jft-t/Rotator-Controller/README.md

# Rotator-Controller
Rotator Controller for SPID BigRAS rotator, suited for use within SatNOGS stations
