jft-t/Rotator-Controller/connections.png

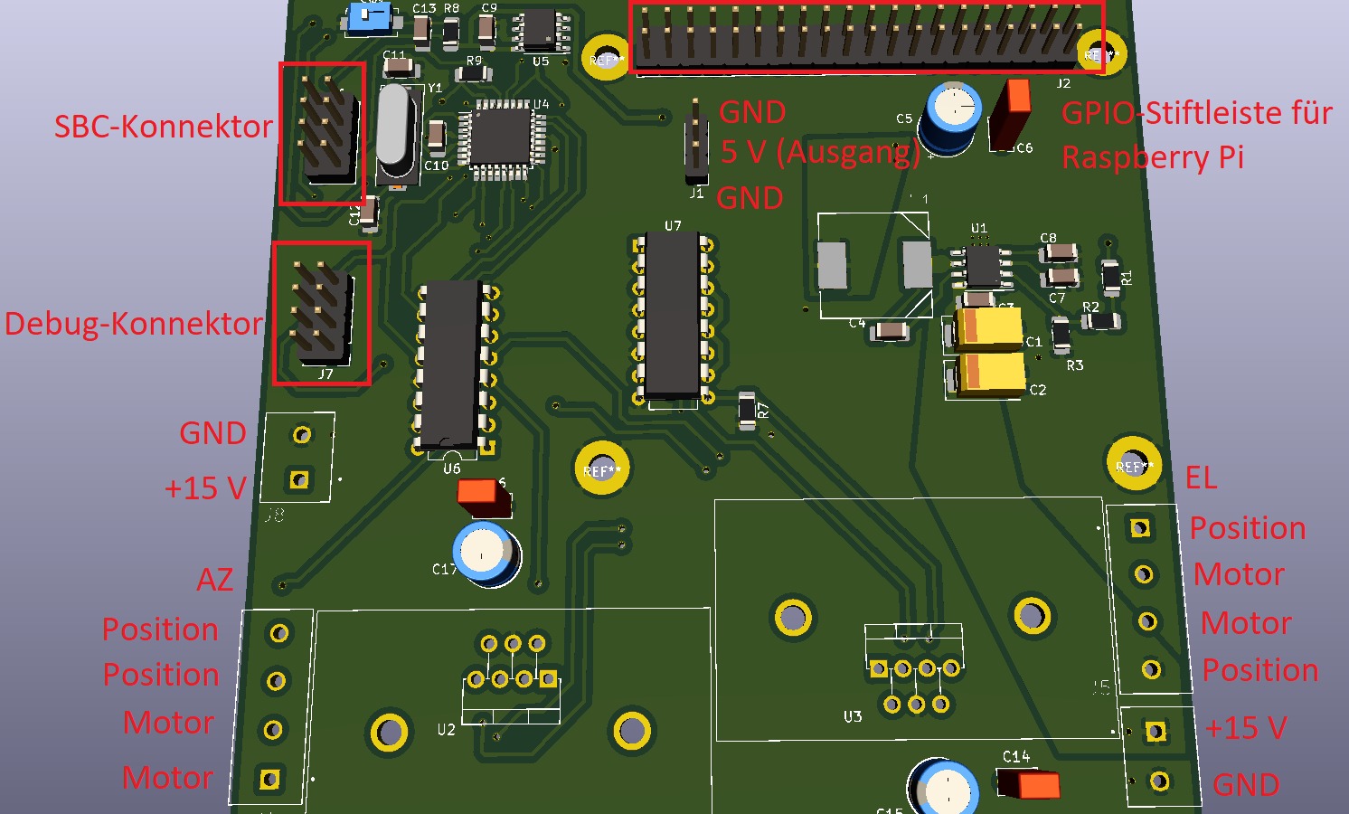
connections.png
