jft-t/Rotator-Controller/bom-controller.xlsx

Sheet: Konnektoren, Schalter
Bezeichnung Schaltplan | Beschreibung | Menge | Einzelpreis in € | Gesamtpreis in € | Link | Bemerkung
J1 | Einfache Stiftleiste | 1 | 0.15 | 0.15 | https://www.pollin.de/p/stiftleiste-vergoldet-1x-7-polig-442428 | wird zurechtgeschnitten
J2 | Stapelbare Stiftleiste für Raspberry Pi | 2 | 1.6 | 3.2 | https://www.sertronics-shop.de/raspberry-pi-co/raspberry-pi/bauelemente/stacking-header-f-252-r-raspberry-2x20-61-40-polig-rm-2-54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 | Abholung im Laden in Adlershof mgl.
J3, J4, J5 | Schraubklemme 2-polig, RM 5mm | 6 | 0.15 | 0.9 | https://www.pollin.de/p/leiterplatten-anschlussklemme-xy301v-2-polig-450856 | J4, J5 durch zusammenstecken
J6, J7 | Stiftleiste, doppelt, 8 Pins, RM 2.54mm | 2 | 0.3 | 0.6 | https://www.pollin.de/p/stiftleiste-450665 | wird zurechtgeschnitten
SW1 | SMD-Taster | 1 | 0.17 | 0.17 | https://www.pollin.de/p/smd-miniatur-eingabetaster-6-1x3-7x2-5-mm-420962
 |  |  |  | 4.7

Sheet: Aktiv
Bezeichnung Schaltplan | Beschreibung | Menge | Einzelpreis in € | Gesamtpreis in € | Link | Bemerkung
U1 | BD9D321EFJ (Buck converter ic) | 1 | 0.64 | 0.64 | https://www.mouser.de/ProductDetail/ROHM-Semiconductor/BD9D321EFJ-E2
U2, U3 | TLE5206-2S Motortreiber | 2 | 4 | 8 | https://www.conrad.de/de/p/infineon-technologies-tle5206-2s-pmic-motortreiber-steuerungen-h-bruecke-parallel-to-220-7-1183765.html | Abholung im Laden in Schöneberg
U4 | ATmega 328P, TQFP-32 | 1 | 1.81 | 1.81 | https://www.mouser.de/ProductDetail/Microchip-Technology-Atmel/ATMEGA328P-AU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
U5 | FM24C04B, F-RAM | 1 | 1.75 | 1.75 | https://www.reichelt.de/fram-4-kb-512-x-8-4-5-5-5-v-so-8-fm-24c04b-g-p146568.html
U6, U7 | Optokoppler LTV-847, 4-Kanal | 2 | 0.71 | 1.42 | https://www.mouser.de/ProductDetail/Lite-On/LTV-847?qs=sGAEpiMZZMteimceiIVCBx3Y662pemTNEFNr76lpuig%3D | wird zurechtgeschnitten
_ | IC-Fassung, 16-polig | 2 | 0.05 | 0.1 | https://www.pollin.de/p/ic-fassung-16-polig-400001
D1 | Z-Diode, 5.1 V, SOD-123 | 1 | 0.24 | 0.24 | https://www.mouser.de/ProductDetail/Vishay-Semiconductors/BZT52C5V1-E3-08
_ | Kühlkörper für TO-220 | 2 | 1.96 | 3.92 | https://www.mouser.de/ProductDetail/Wakefield-Vette/657-25ABEP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 | für 10 bis 14 W Wärmeverluste
 |  |  |  | 13.96

Sheet: Passiv
Bezeichnung Schaltplan | Beschreibung | Menge | Einzelpreis in € | Gesamtpreis in € | Link | Bemerkung
C1, C2 | SMD-Tantalkondensator 33 µF | 2 | 0.1 | 0.2 | https://www.pollin.de/p/smd-tantal-kondensator-210448 | nur 2 benötigt
C3, C4, C9, C10, C13 | SMD-Kermaikkondensator 100 nF | 5 | 0.1 | 0.5 | https://www.mouser.de/ProductDetail/KEMET/C1206C104M5RACTU?qs=sGAEpiMZZMs0AnBnWHyRQAyQ3AEn5kTUXS61cVd4nXQ%3D
C5 | Elektrolytkondensator 100 µF | 1 | 0.28 | 0.28 | https://www.mouser.de/ProductDetail/Panasonic/EEU-FR1E101?qs=sGAEpiMZZMvwFf0viD3Y3chMjVlP8qMGKQRWWtuhRU4%3D | Low-ESR
C6, C14, C16 | Keramikkondensator 100 nF | 3 | 0.06 | 0.18 | https://www.pollin.de/p/keramik-vielschicht-kondensator-100-nf-201048
C7 | SMD-Kermaikkondensator 1 µF | 1 | 0.25 | 0.25 | https://www.mouser.de/ProductDetail/Wurth-Electronics/885012208064
C8 | Keramikkondensator 3,3 nF | 1 | 0.06 | 0.06 | https://www.mouser.de/ProductDetail/Vishay-Vitramon/VJ1206Y332JXAAC
C10, C11 | SMD-Keramikkondensator 22 pF | 2 | 0.11 | 0.22 | https://www.mouser.de/ProductDetail/Wurth-Electronics/885012008039
C15, C17 | Elektrolytkondensator 100 µF | 2 | 0.1 | 0.2 | https://www.pollin.de/p/elko-jamicon-low-e-s-r-100-f-25-v-rm2-5-1050-radial-210874
L1 | SMD-Spule, 100 µH, 3.64 A | 1 | 1.77 | 1.77 | https://www.mouser.de/ProductDetail/Coiltronics-Eaton/DR127-101-R
R1 | SMD-Dickfilmwiderstand, 110k, 0.5 % | 1 | 0.29 | 0.29 | https://www.mouser.de/ProductDetail/Yageo/RT1206DRD07110KL | Hohe Genauigkeit für Tiefsetzsteller
R2 | SMD-Dickfilmwiderstand, 16k, 0.5 % | 1 | 0.29 | 0.29 | https://www.mouser.de/ProductDetail/Susumu/RG3216P-1602-D-T5?qs=sGAEpiMZZMtlubZbdhIBIGPl8NE4eY1fxwWHEzzjGgg%3D | Hohe Genauigkeit für Tiefsetzsteller
R3 | SMD-Dickfilmwiderstand, 22k, 0.5 % | 1 | 0.23 | 0.23 | https://www.mouser.de/ProductDetail/KOA-Speer/SG73G2BTTD2202D | Hohe Genauigkeit für Tiefsetzsteller
R4, R5, R6, R7, R8, R17, R18 | SMD-Dickfilmwiderstand, 10k, 1 % | 7 | 0.09 | 0.63 | https://www.mouser.de/ProductDetail/Vishay-Dale/CRCW120610K0FKEAC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
R9 | SMD-Dickfilmwiderstand, 2k4, 1 % | 1 | 0.09 | 0.09 | https://www.mouser.de/ProductDetail/Vishay-Dale/CRCW12062K40FKEAC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 | Hohe Genauigkeit für UART
R10 | SMD-Dickfilmwiderstand, 4k7, 1 % | 1 | 0.09 | 0.09 | https://www.mouser.de/ProductDetail/Panasonic/ERJ-8ENF4701V?qs=sGAEpiMZZMtlubZbdhIBIOIpaOjkYUZGnQsJq1RaWsg%3D | Hohe Genauigkeit für UART
R11, R12, R13, R14, R15, R16 | SMD-Dickfilmwiderstand, 620, 1 % | 6 | 0.09 | 0.54 | https://www.mouser.de/ProductDetail/Panasonic/ERJ-8ENF6200V
Y1 | Quarz-Kristall, 16 MHz, HC-49 | 1 | 0.26 | 0.26 | https://eu.mouser.com/ProductDetail/IQD/LFXTAL010495Bulk
R19 | SMD-Dickfilmwiderstand, 10, 1 % | 1 | 0.09 | 0.09 | https://www.mouser.de/ProductDetail/Vishay-Dale/CRCW120610R0FKEAC
F1 | SMD-Sicherung, 3.5 A, träge | 1 | 0.2 | 0.2 | https://www.pollin.de/p/smd-sicherung-mit-fassung-littelfuse-015403-5t-260597 | für 5 V-Spannungsversorgung
 |  |  |  | 6.37
