jft-t/Rotator-Controller/kicad/controller.kicad_pcb

## KiCad design kicad/controller.kicad_pcb (2019-08-09)

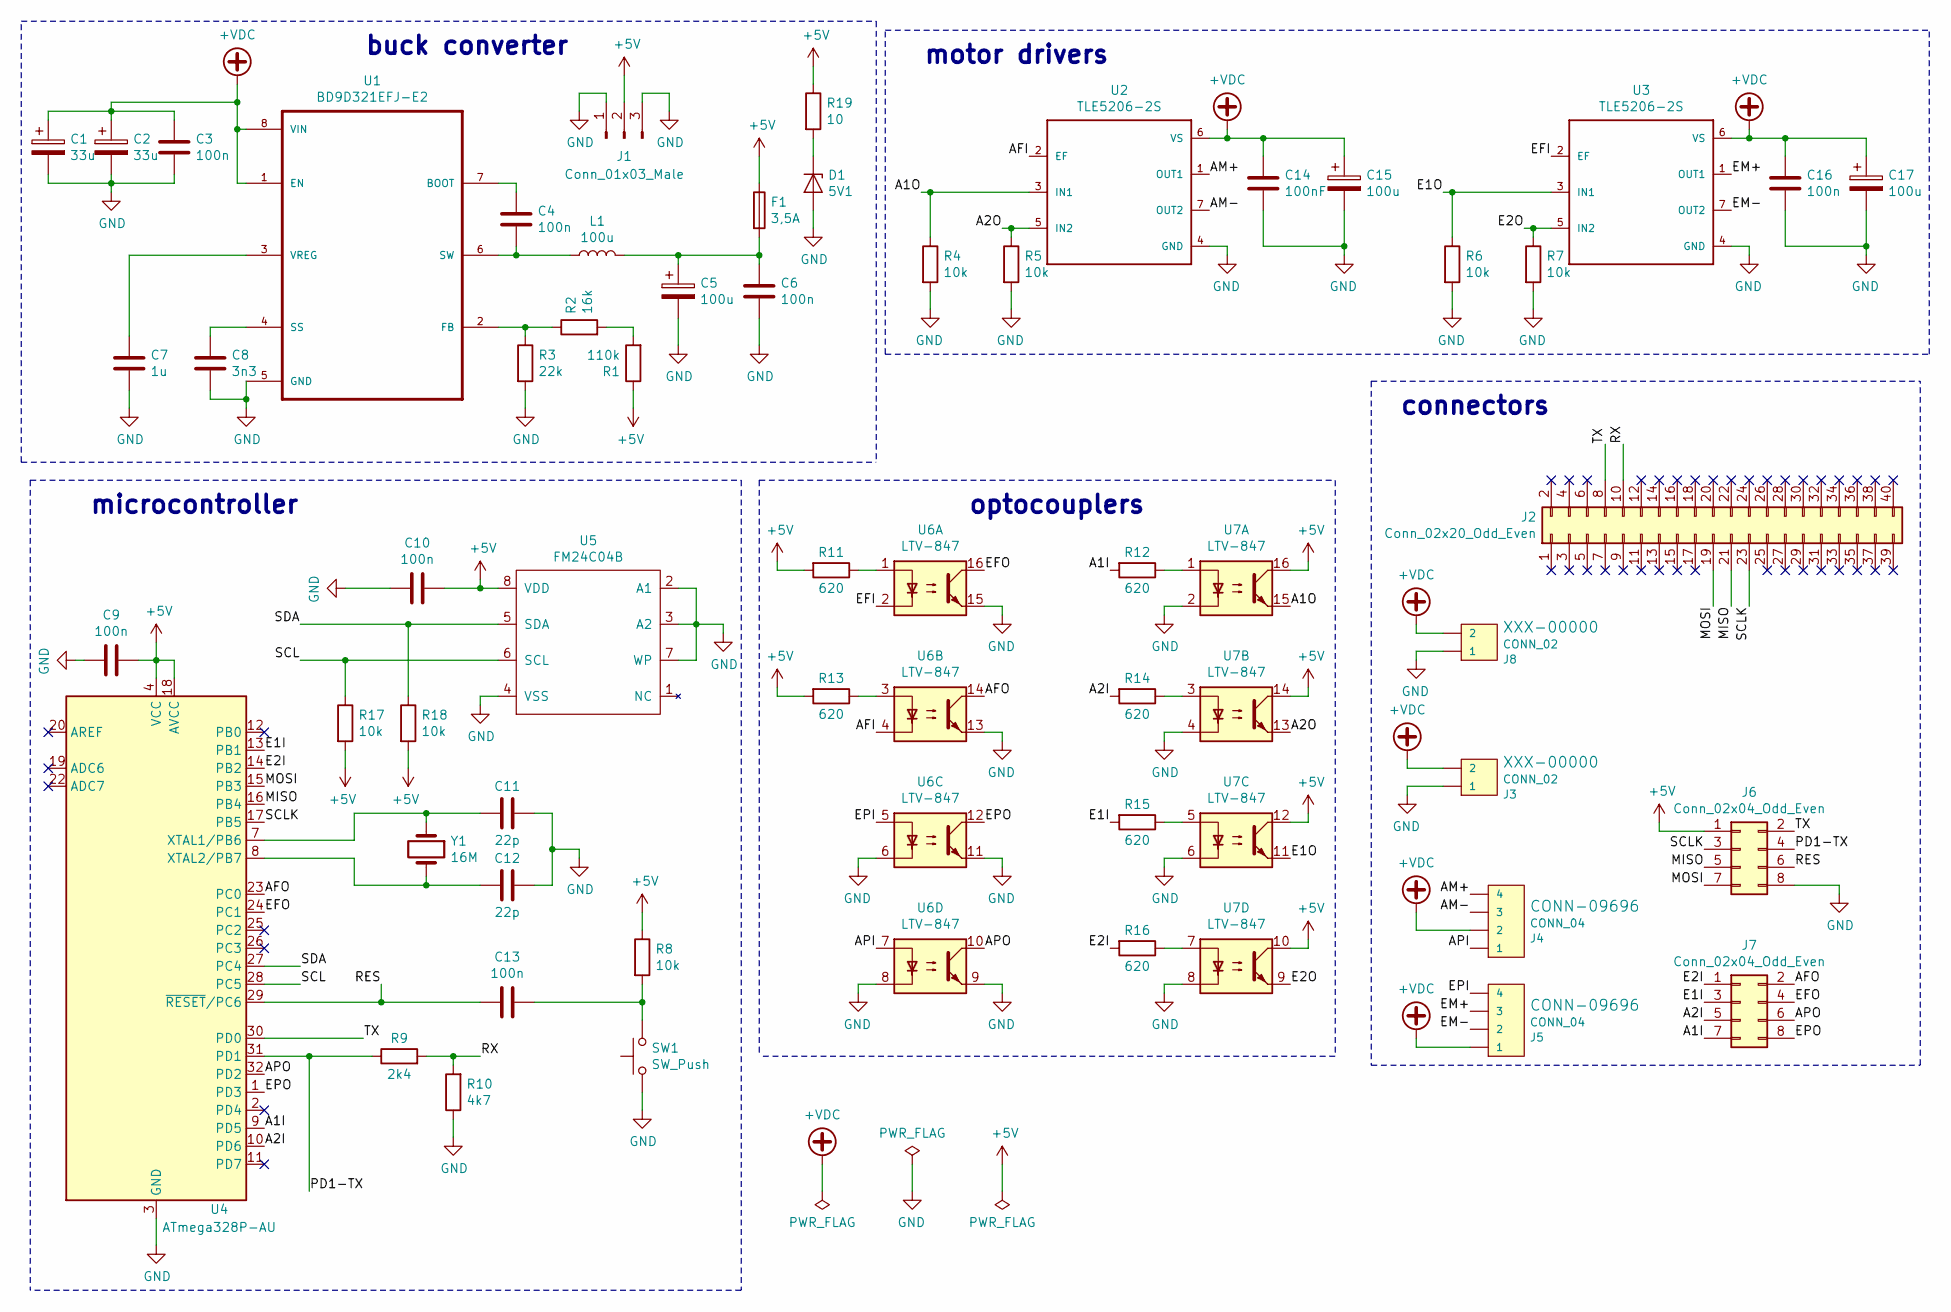
[picture p2: schematic controller.sch, bigras-rotator-controller]

Parts:
C1, C2: 33u; CP_EIA-7343-40_Kemet-Y_Pad2.25x2.55mm_HandSolder
C3, C4, C9, C10, C13: 100n; C_1206_3216Metric_Pad1.42x1.75mm_HandSolder
C5, C15, C17: 100u; CP_Radial_D6.3mm_P2.50mm
C6, C16: 100n; C_Rect_L4.0mm_W2.5mm_P2.50mm
C7: 1u; C_1206_3216Metric_Pad1.42x1.75mm_HandSolder
C8: 3n3; C_1206_3216Metric_Pad1.42x1.75mm_HandSolder
C11, C12: 22p; C_1206_3216Metric_Pad1.42x1.75mm_HandSolder
C14: 100nF; C_Rect_L4.0mm_W2.5mm_P2.50mm
D1: 5V1; D_SOD-123
F1: 3,5A; 154-series
J1: Conn_01x03_Male; PinHeader_1x03_P2.54mm_Vertical
J2: Conn_02x20_Odd_Even; PinHeader_2x20_P2.54mm_Vertical
J3, J8: CONN_02; CUI_TB002-500-02BE
J4, J5: CONN_04; CUI_TB002-500-04BE
J6, J7: Conn_02x04_Odd_Even; PinHeader_2x04_P2.54mm_Vertical
L1: 100u; DR127
R1: 110k; R_1206_3216Metric_Pad1.42x1.75mm_HandSolder
R2: 16k; R_1206_3216Metric_Pad1.42x1.75mm_HandSolder
R3: 22k; R_1206_3216Metric_Pad1.42x1.75mm_HandSolder
R4, R5, R6, R7, R8, R17, R18: 10k; R_1206_3216Metric_Pad1.42x1.75mm_HandSolder
R9: 2k4; R_1206_3216Metric_Pad1.42x1.75mm_HandSolder
R10: 4k7; R_1206_3216Metric_Pad1.42x1.75mm_HandSolder
R11, R12, R13, R14, R15, R16: 620; R_1206_3216Metric_Pad1.42x1.75mm_HandSolder
R19: 10; R_1206_3216Metric_Pad1.42x1.75mm_HandSolder
SW1: SW_Push; SW_SPST_EVQPE1
U1: BD9D321EFJ-E2; HSOP-8-1EP_3.9x4.9mm_P1.27mm_EP2.41x3.1mm
U2, U3: TLE5206-2S; TO-220-7_P2.54x3.7mm_StaggerEven_Lead3.8mm_Vertical
U4: ATmega328P-AU; TQFP-32_7x7mm_P0.8mm
U5: FM24C04B; SOIC-8_3.9x4.9mm_P1.27mm
U6, U7: LTV-847; DIP-16_W7.62mm
Y1: 16M; Crystal_SMD_HC49-SD

Connections:
+5V: C9.1, C10.1, F1.1, J1.2, J6.1, R1.1, R8.1, R11.2, R13.2, R17.2, R18.2, R19.1, U4.4 (VCC), U4.6 (VCC), U4.18 (AVCC), U5.8 (VDD), U7.10, U7.12, U7.14, U7.16
+VDC: C1.1, C2.1, C3.2, C14.1, C15.1, C16.1, C17.1, J3.2, J4.2, J5.1, J8.2, U1.1 (EN), U1.8 (VIN), U2.6 (VS), U3.6 (VS); also elsewhere on the board
/A1I: J7.7, R12.2, U4.9 (PD5)
/A1O: R4.1, U2.3 (IN1), U7.15
/A2I: J7.5, R14.2, U4.10 (PD6)
/A2O: R5.1, U2.5 (IN2), U7.13
/AFI: U2.2 (EF), U6.4
/AFO: J7.2, U4.23 (PC0), U6.14
/AM+: J4.4, U2.1 (OUT1)
/AM-: J4.3, U2.7 (OUT2)
/API: J4.1, U6.7
/APO: J7.6, U4.32 (PD2), U6.10
/E1I: J7.3, R15.2, U4.13 (PB1)
/E1O: R6.1, U3.3 (IN1), U7.11
/E2I: J7.1, R16.2, U4.14 (PB2)
/E2O: R7.1, U3.5 (IN2), U7.9
/EFI: U3.2 (EF), U6.2
/EFO: J7.4, U4.24 (PC1), U6.16
/EM+: J5.3, U3.1 (OUT1)
/EM-: J5.2, U3.7 (OUT2)
/EPI: J5.4, U6.5
/EPO: J7.8, U4.1 (PD3), U6.12
/MISO: J2.21, J6.5, U4.16 (PB4)
/MOSI: J2.19, J6.7, U4.15 (PB3)
/PD1-TX: J6.4, R9.1, U4.31 (PD1)
/RES: C13.2, J6.6, U4.29 (~RESET~/PC6)
/RX: J2.10, R9.2, R10.2
/SCL: R17.1, U4.28 (PC5), U5.6 (SCL)
/SCLK: J2.23, J6.3, U4.17 (PB5)
/SDA: R18.1, U4.27 (PC4), U5.5 (SDA)
/TX: J2.8, J6.2, U4.30 (PD0)
GND: C1.2, C2.2, C3.1, C5.2, C6.2, C7.2, C8.2, C9.2, C10.2, C11.1, C12.1, C14.2, C15.2, C16.2, C17.2, D1.2 (A), J1.1, J1.3, J3.1, J6.8, J8.1, R3.2, R4.2, R5.2, R6.2, R7.2, R10.1, SW1.1, U1.5 (GND), U2.4 (GND), U3.4 (GND), U4.3 (GND), U4.5 (GND), U4.21 (GND), U5.2 (A1), U5.3 (A2), U5.4 (VSS), U5.7 (WP), U6.6, U6.8, U6.9, U6.11, U6.13, U6.15, U7.2, U7.4, U7.6, U7.8; also elsewhere on the board
unnamed: C4.1, U1.7 (BOOT)
unnamed: C4.2, L1.1, U1.6 (SW)
unnamed: C5.1, C6.1, F1.2, L1.2
unnamed: C7.1, U1.3 (VREG)
unnamed: C8.1, U1.4 (SS)
unnamed: C11.2, U4.7 (XTAL1/PB6), Y1.1
unnamed: C12.2, U4.8 (XTAL2/PB7), Y1.2
unnamed: C13.1, R8.2, SW1.2
unnamed: D1.1 (K), R19.2
unnamed: R1.2, R2.2
unnamed: R2.1, R3.1, U1.2 (FB)
unnamed: R11.1, U6.1
unnamed: R12.1, U7.1
unnamed: R13.1, U6.3
unnamed: R14.1, U7.3
unnamed: R15.1, U7.5
unnamed: R16.1, U7.7

Notes on the sheet:
microcontroller
optocouplers
motor drivers
connectors
buck converter

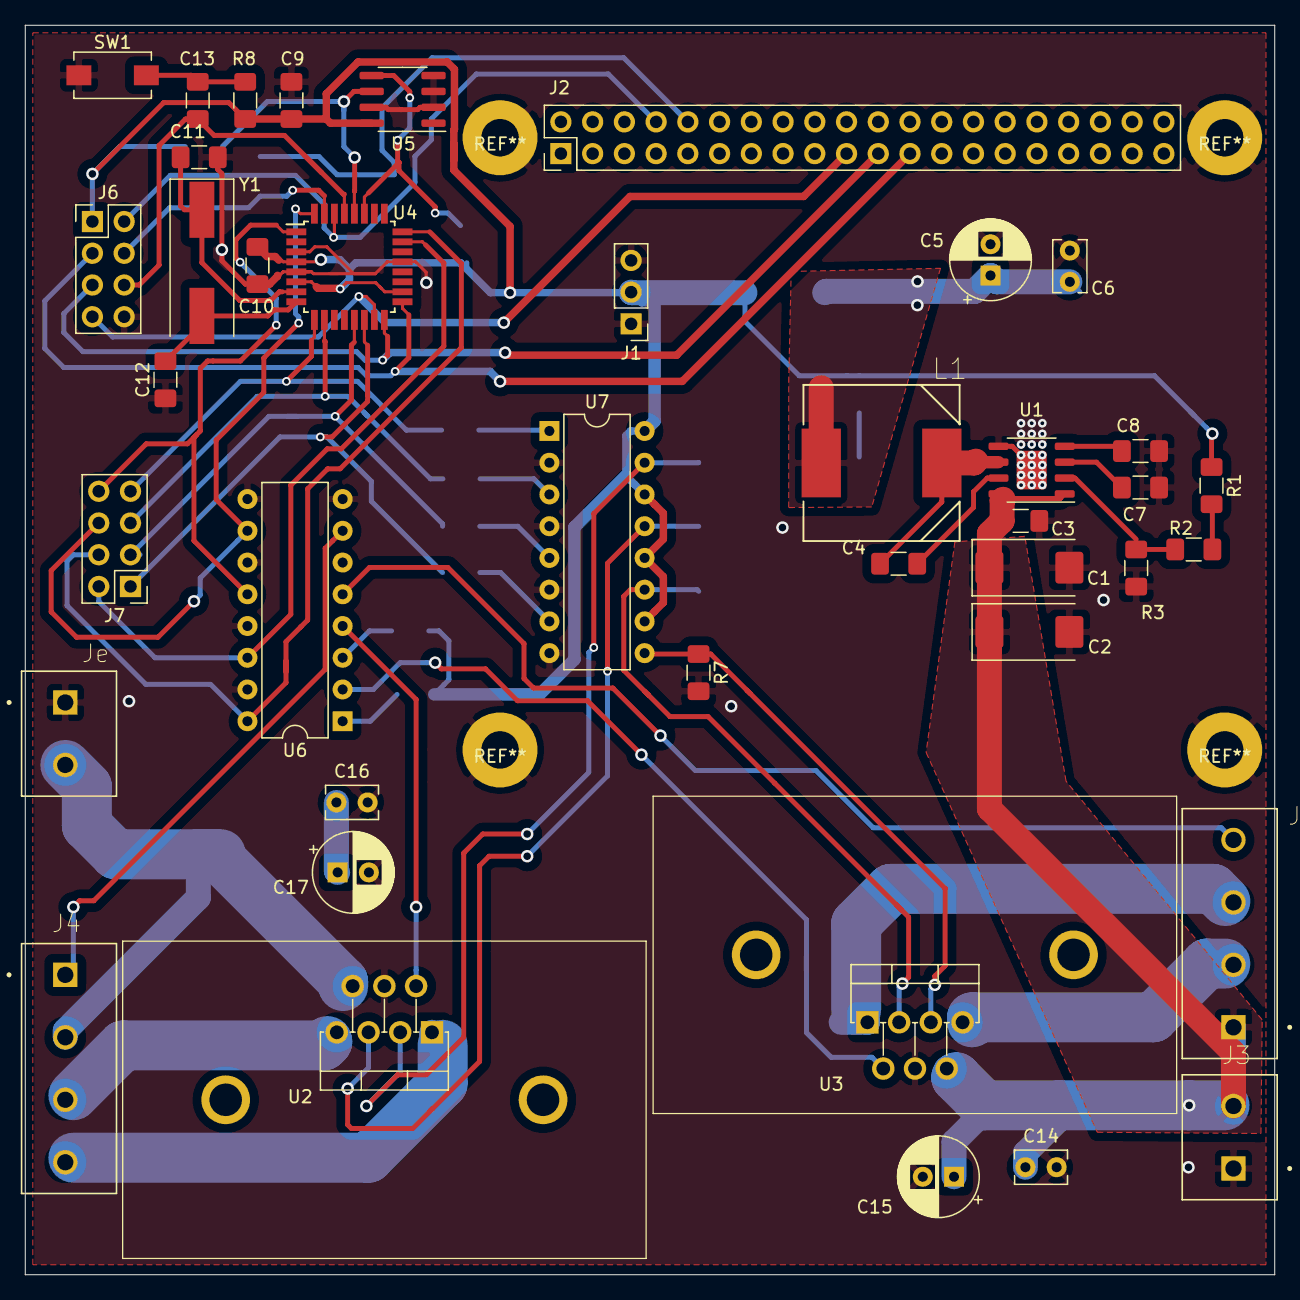
[picture p3: board controller.kicad_pcb from above]

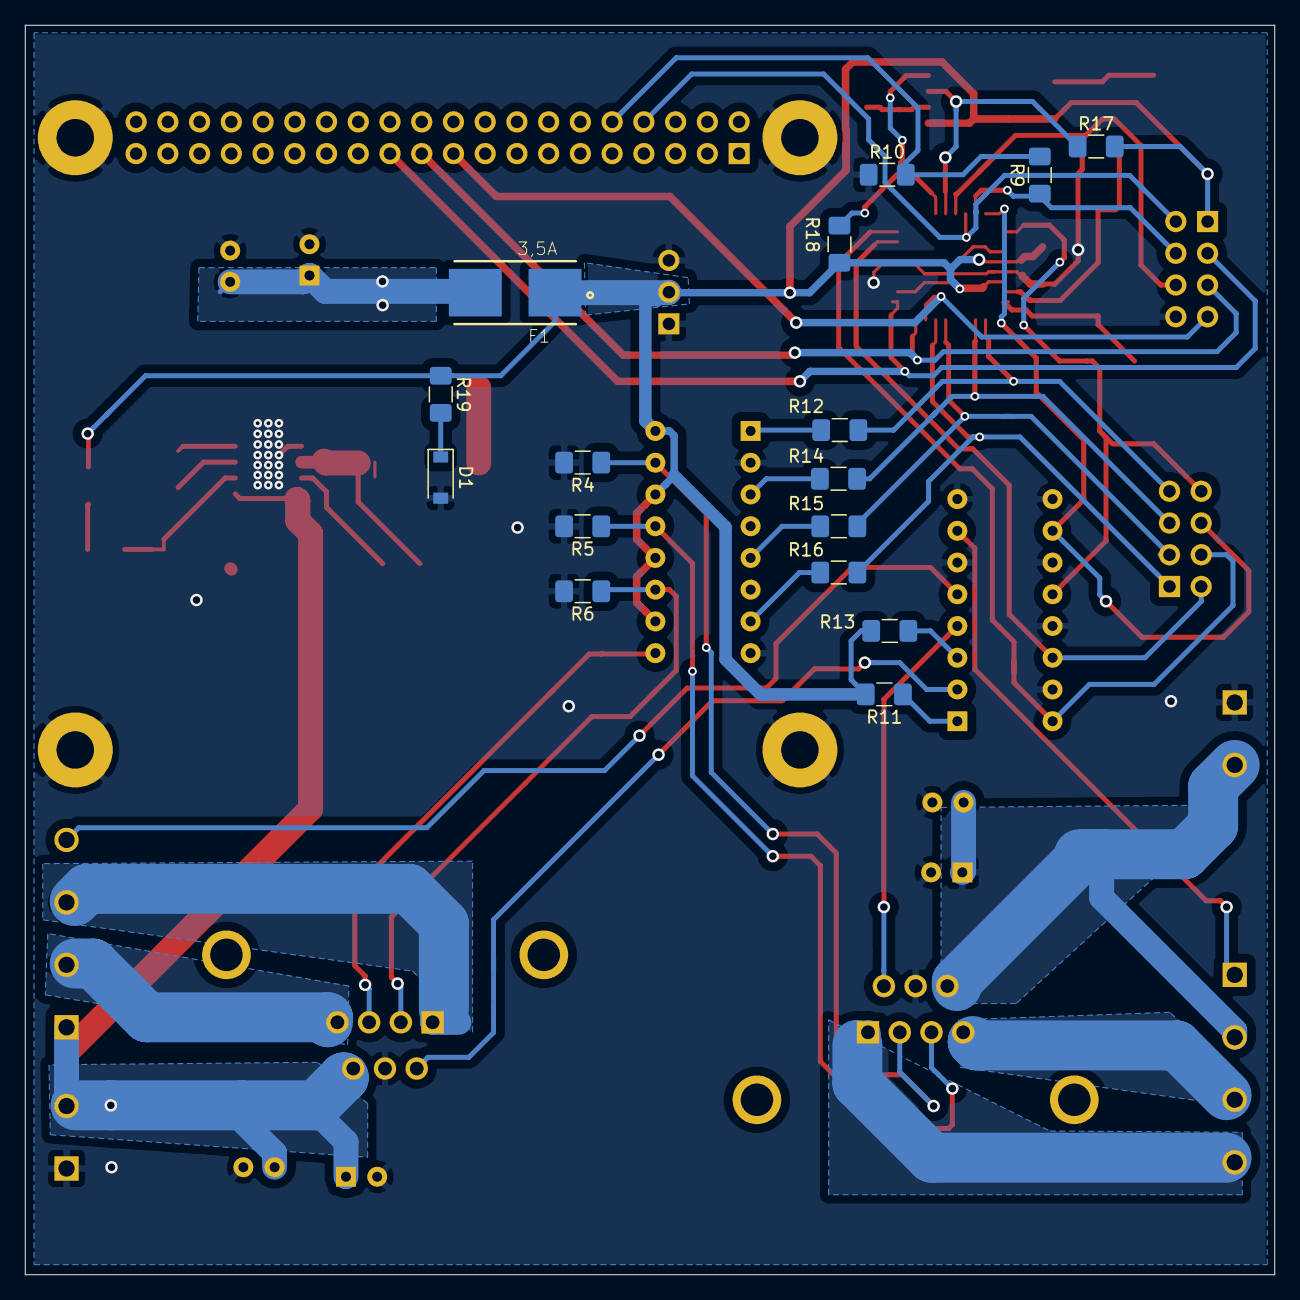
[picture p4: board controller.kicad_pcb from below]

Board: 2 copper layers, 100.0 x 100.0 mm, 58 parts (16 on the bottom side), 49 nets.

Other parts of the board:
H**: 65725ABEP
H**#2: 65725ABEP
Je: CONN_02; CUI_TB002-500-02BE

Their connections:
+VDC: Je.2; also elsewhere on the board
GND: Je.1; also elsewhere on the board
